Craftsman1579/lily58-keycaps/docs/adr/0012-case-tray-with-plate.md

# 0012 – Case: printed tray with a switch plate

- **Status:** proposed (draft v8, M2 standoffs in both variants; tenting pockets; snap, pocket size to be tuned)
- **Decided by:** owner (tray with plate, M2 screws and standoffs, no OLED, feet, tenting later,
  separate branch), derived (geometry)

## Context

The owner's board is a **PandaKB Lily58 RGB MX**: a Lily58 Pro derivative with hotswap MX sockets,
per-key and underglow RGB (underglow LEDs face down), two optional EC11 encoders in place of two
keys, ProMicro RP2040 (USB-C), TRRS, OLED. PandaKB publishes no PCB files. The original Lily58 Pro
KiCad file (kata0510/Lily58, MIT) is the best available source – and it fits: the 1:1 paper
template matches the owner's PCB exactly.

## Decision

- **Layout data** (`common/lily58_layout.scad`) is generated by `tools/kicad2scad.py` from
  `Pro/PCB/Lily58_Pro.kicad_pcb`: outline, 29 switch positions with rotation, 5 standoff holes
  (4.7 mm), 2 OLED holes, Pro Micro, TRRS, reset. The PCB is reversible; the data describe the right
  half from the top, the left half is the mirror image. Shared by the case and (later) the cap
  renders – the 1.5u thumb is rotated by 300° (30° from vertical), not 90° as in `tools/scene.py`.
- **Tray with plate** (`case/lily58_case.scad`): the tray follows the PCB outline (gap 0.6 mm,
  wall 4 mm, floor 3.6 mm, 3 mm 45° bevel round the bottom edge). Plate top = PCB top + 5 mm.
- **Plate over the wall, snapped in** (owner, v5: the plate sat loose in a rebate and looked
  poor): the plate (1.5 mm, MX) covers the wall top flush with the outside, its top edge with a 0.8 mm
  45° chamfer (owner: must print cleanly – the plate prints top down, a radius on the bed side
  would overhang too flat, a 45° chamfer does not). A tongue under its edge (1.2 mm, with a 1.5 mm bulge near the tip) clicks into a groove
  in the middle of the wall top (1.4 mm neck widening to 1.7 mm, 2 mm deep). The groove runs all
  round, also along the open controller zone, where a later cover can use it. `part="snap_test"`
  prints a 30 mm piece of wall and plate edge to tune the profiles. Plates are right and left
  again (the tongue is on one side) and are printed top down.
- **As flat as possible** (owner's wish, v3): plate top 15.2 mm above the desk (v2: 17.9); 16.8 mm
  since the tenting pockets (v7) need a 3.6 mm floor. Only
  the 5 mm PCB-to-plate-top of MX and the 3.5 mm parts below the PCB are fixed; the rest was
  trimmed (standoffs → bosses −2.3, floor −0.4). The keycaps (DES vs KAT) matter more
  than anything left in the case.
- **M2 hex standoffs, like the Choc variant** (owner, v8: liked the Choc mounting): an M2 standoff
  (female both ends, 2.7 mm across flats, passes the 4.7 mm PCB hole) sits in a hex pocket in each
  tray boss (Ø 6.5 mm, 4.0 mm high: the 3.5 mm parts below + 0.5). MX uses **10 mm** standoffs
  (z 2.6–12.6), ending 0.1 mm below the plate; sleeves under the plate (Ø 5.2 / 3.6 mm, the nearest
  switch housing is 2.9 mm from a hole centre) stand on the PCB, so the top screw clamps plate,
  sleeve and PCB onto the tray boss. M2x4 from below (2.5 mm of thread), M2x4 from the top (3.5 mm);
  both heads (Ø 3.7 × 1 mm, recesses Ø 4.1) flush in 1.1 mm recesses. Metal threads both ways instead of v6's M3x10
  tapping into a plastic boss. Earlier variants are in the history of this file.
- **Assembly:** standoffs into the pockets, M2x4 from below; PCB onto the tray bosses; plate with
  the switches on top (it snaps into the groove, the switches go into the hotswap sockets); M2x4 from
  the top through the plate into the standoffs.
- **No OLED** (owner's choice, v4): the plate leaves the controller zone open (x < 28.5, y > 55.5).
  Its edge towards the bottom row is 1.0 mm clear of the nearest keycap, so the cover keeps 1.3 mm
  between its edge and the screw head recesses.
- **Controller cover** (`part="cover"`, owner: 7.7 mm above the PCB, clicks into the tray): a 1.5 mm
  top whose underside is 7.7 mm above the PCB top (Pro Micro: 7.4 mm), walls on the tray wall with
  the plate's tongue in the groove, 1.5 mm inner walls along the plate edge (0.2 mm gap) down to the
  plate top, and two Ø 4.5 mm posts that press on the PCB round the two cover (OLED) holes. An M2x12
  from the top (head flush) goes through the cover and the PCB into a heat-set insert (3.9 mm across
  flats, 1.5 mm long) in the tray ring below the PCB: Ø 3.6 × 1.8 mm melt-in hole, then 2 mm room
  for the screw tip (it ends 0.8 mm below the insert). The screw clamps the PCB between post and
  ring. Printed top down. 45° chamfers on the top edges (owner): 3 mm along the case outline like the
  tray's bottom bevel, 0.8 mm along the plate like the plate's edge (the inner walls are 1.5 mm),
  1 mm on the vertical corner towards the keys. The USB plug reaches 9.15 mm above the PCB, the
  cover top 9.2 mm, so both port slots are open to the top of the cover (U-notches).
- **USB and TRRS** get rounded slots through the top wall, 2 mm closer to the
  inner edge than the KiCad positions (owner's test print). USB-C 16 × 10.5 mm (13 × 7.5 was too
  tight for the owner's cables), TRRS 9.5 × 8.5 mm; the two merge into one opening (hull), since
  the bridge between them would only be 0.35 mm. The Choc tray wall ends below the USB
  slot, so the Choc tray keeps separate slots and is unchanged; only its cover is new.
- **Rubber feet:** Ø 8 × 4 mm, recessed 1.4 mm (pockets Ø 8.4 mm, 0.6 mm floor above), sticking
  out 2.6 mm; five per half (the fifth in the thumb cluster tip, out to the chamfer, so the tip
  is supported; it is the front foot that clicks in behind the travel sleeve detent). Thinner feet
  (e.g. 8 × 2 mm) would save another 1.6 mm.
  The outer pair sits at x 139.9 (pockets reach the start of the bottom chamfer): tented, the half pivots
  on them. At x 132 the fully unfolded tenting feet (27°, inner edge 82.5 mm up, owner) tipped it
  onto its bottom edge and the rubber feet lost contact (from 18° on, now from 62° on). Moving the
  tenting pockets inwards would not have helped: even at x 0 the tilt stays at 23°, and the thumb
  screw blocks the front pocket.
- **Tenting** (v7): two folding feet per half (owner's, housing 66 × 20 × 5.5 mm, hinge on a short
  side) sit in pockets in the bottom, long side across the inner edge: one below the controller
  zone against the long back edge, just behind a screw head (y 87.3–107.6), one by the thumb cluster
  (y 12–32), both from x 25.5 to 91.8 – aligned, so the
  unfolded feet lift the half evenly (owner); the thumb cluster and its screw allow no smaller x –
  and clear of the five screw heads. The pockets are 2.9 mm deep, so the housings stick out 2.6 mm like the rubber feet
  and sit flush with them (owner's wish); that needs a 3.6 mm floor (0.7 mm above the pockets).
  The rubber foot by the thumb cluster moved to (12, 42).
- **Switch cutout 13.8 mm** (printed holes come out smaller than drawn). Confirmed by the plate fit
  test (`part="plate_test"`, 13.7–14.0 mm): the cutout with two notches (13.8) fits best (owner).
- **Choc variant** (`switch_type="choc"`, files `*_choc.stl`) for the owner's second Lily58 with
  Choc v1 switches at MX spacing: with the MX plate height the switches hung in the air above the
  PCB. The 1.9 mm plate now lies directly on the PCB (plate_above = plate_t = 1.9), so the tray wall
  ends at the PCB top. No plate bosses; instead **M2 hex standoffs** (owner's, female both ends,
  6 mm, 2.7 mm across flats / 3.1 across corners, so they pass the 4.7 mm PCB holes) sit in hex
  pockets in the tray bosses (z 3.1–9.1, 0.1 mm below the PCB top). An M2x4 from below holds each
  standoff, an M2x4 from the top pulls the plate onto the PCB and the PCB onto the boss; both heads
  (Ø 3.7 × 1 mm, recesses Ø 4.1) sit flush in 1.1 mm recesses. Metal threads both ways instead of the first draft's
  M3x6 tapping 1.3 mm into the plate (owner's idea). Same PCB outline, holes,
  ports and clearance below the PCB assumed as on the MX board – not measured on the Choc board.
- **1:1 paper template** (`template.pdf`/`.svg`, 100 mm scale bar) to lay the real PCB on.
- Work happens on the branch `lily58-case` until the case is verified.

## Measurements (MEASURE n in the code)

1. PCB size and thickness – confirmed with the paper template.
2. Standoff holes – confirmed with the paper template.
3. Encoders – not answered; the 14 mm plate cutout takes an EC11 shaft anyway.
4. USB-C centre 5.4 mm above the PCB top, no overhang.
5. TRRS jack axis 3.7 mm above the PCB centre (2.9 mm above its top). Position along the edge:
   from the KiCad data, the 9.5 mm slot covers both footprint variants.
6. OLED: removed by the owner.
7. Tallest part below the PCB 3.5 mm; area around the five holes is free.
8. No plate in the kit – the printed plate is the plate.
9. No wireless/battery.
10. Reset switch on the top, about 3.5 mm high.
11. (OLED window – obsolete.)
12. Highest point of the Pro Micro: 9.0 mm above the PCB bottom = 7.4 mm above its top.
13. M2 standoffs: 4/6/8/10 mm, 2.7 mm across flats (re-measured); MX uses 10 mm, Choc 6 mm.
17. Folding feet housing: 66 × 20 × 5.5 mm (pockets + 0.3 mm); exact size to confirm.
14. Switch cutout: 13.8 mm – confirmed by the plate fit test.
19. Cover (OLED) holes on the owner's PCB: Ø 2.1 mm, centres at x 2.2 / 25.05 mm from the inner
    edge, 47.25 mm below the top edge (Lily58 Pro data: 3.06 / 25.06, 47.91, Ø 2.4). Measured edge
    to edge from the PCB and from the case outside; both agree. Choc board not measured.
20. Heat-set inserts M2: 3.9 mm across flats, 1.5 mm long; screws M2 x 10/12/16/20.

## Consequences

- All parts are ready for a first test print; the switch cutout is confirmed.
- `case/build.sh` exports to `stl/case/`; check every part with `tools/f32.py` and `tools/shells.py`.

## Images

Both boards, rendered by `render/case.sh` (scene `render/case_scene.scad`): assembled, exploded,
section and controller cover for [MX](../img/case/mx_exploded.png) and
[Choc](../img/case/choc_exploded.png) (`docs/img/case/<board>_*.png`), and the
[bottom of the right tray](../img/case/bottom.png) (rubber feet black, tenting feet orange, M2 screws
grey; inner edge on the right).
