Craftsman1579/lily58-keycaps/docs/img/case/choc_carry2_section.png

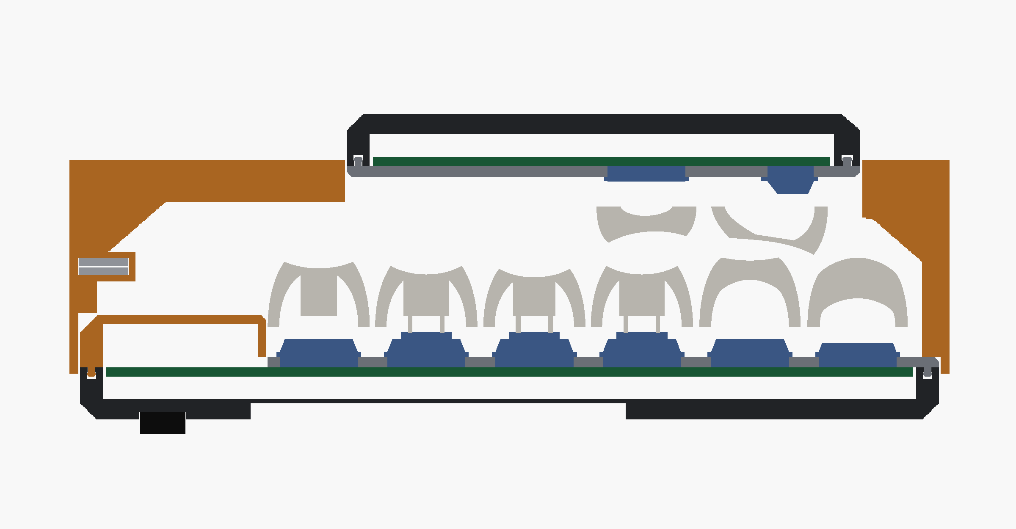
docs/img/case/choc_carry2_section.png
