Craftsman1579/lily58-keycaps/docs/img/case/mx_carry2.png

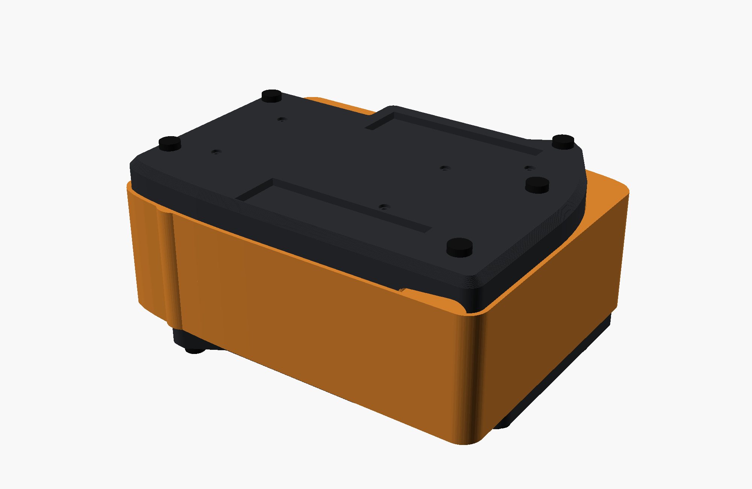
docs/img/case/mx_carry2.png
