Craftsman1579/lily58-keycaps/docs/img/case/mx_carry2_section.png

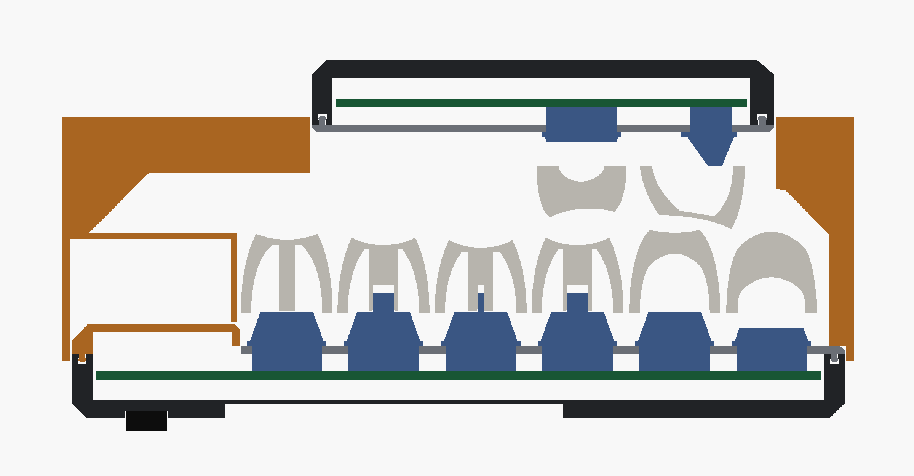
docs/img/case/mx_carry2_section.png
