Craftsman1579/lily58-keycaps/common/lily58_layout.scad

// Generated by tools/kicad2scad.py from kata0510/Lily58 Pro/PCB/Lily58_Pro.kicad_pcb
// (MIT, (c) 2018 Naoki Katahira). Do not edit by hand.
// RIGHT half seen from the switch side, mm, y up, origin = lower left of the PCB bbox.
// The left half is mirror([1, 0, 0]) of everything here.

lily58_pcb_thickness = 1.6;
lily58_pcb_size = [142.522, 106.327];

lily58_pcb_outline = [
  [33.249, 6.933], [34.925, 7.903], [42.295, 7.902], [49.665, 7.902], [57.034, 7.902], [64.404, 7.902],
  [71.773, 7.902], [79.143, 7.902], [86.512, 7.902], [93.882, 7.902], [94.184, 7.933], [94.466, 8.02],
  [94.721, 8.158], [94.943, 8.341], [95.126, 8.563], [95.264, 8.818], [95.351, 9.1], [95.382, 9.402],
  [95.382, 10.598], [95.382, 11.816], [95.382, 13.034], [95.382, 14.252], [95.382, 15.47], [95.382, 16.688],
  [95.382, 17.906], [95.382, 19.124], [95.453, 19.83], [95.657, 20.487], [95.979, 21.082], [96.406, 21.6],
  [96.924, 22.027], [97.519, 22.349], [98.176, 22.553], [98.882, 22.624], [104.149, 22.624], [109.417, 22.624],
  [114.685, 22.624], [119.952, 22.624], [125.22, 22.624], [130.487, 22.624], [135.755, 22.624], [141.022, 22.624],
  [141.325, 22.655], [141.607, 22.742], [141.861, 22.88], [142.083, 23.063], [142.266, 23.285], [142.405, 23.54],
  [142.492, 23.822], [142.522, 24.124], [142.522, 33.606], [142.522, 43.087], [142.522, 52.569], [142.522, 62.051],
  [142.522, 71.532], [142.522, 81.014], [142.522, 90.496], [142.522, 99.977], [141.341, 101.258], [137.952, 102.45],
  [132.588, 103.529], [125.483, 104.468], [116.87, 105.243], [106.982, 105.829], [96.052, 106.198], [84.313, 106.327],
  [73.906, 106.327], [63.498, 106.327], [53.09, 106.327], [42.682, 106.327], [32.274, 106.327], [21.866, 106.327],
  [11.459, 106.327], [1.051, 106.327], [0.839, 106.306], [0.642, 106.245], [0.463, 106.148], [0.308, 106.02],
  [0.18, 105.864], [0.083, 105.686], [0.022, 105.489], [0.001, 105.277], [0, 98.97], [0, 92.663],
  [0, 86.356], [0, 80.049], [0, 73.743], [0, 67.436], [0, 61.129], [0, 54.822],
  [0.198, 50.796], [0.553, 46.756], [1.083, 42.723], [1.81, 38.719], [2.75, 34.765], [3.926, 30.883],
  [5.354, 27.096], [7.056, 23.424], [8.731, 20.559], [10.407, 17.693], [12.082, 14.827], [13.758, 11.96],
  [15.434, 9.094], [17.11, 6.228], [18.785, 3.361], [20.461, 0.495], [20.554, 0.326], [20.66, 0.191],
  [20.777, 0.091], [20.905, 0.028], [21.044, 0], [21.193, 0.01], [21.351, 0.057], [21.519, 0.142],
  [23.195, 1.112], [24.871, 2.082], [26.546, 3.053], [28.222, 4.023], [29.898, 4.993], [31.573, 5.963],
];

// [x, y, rotation, row, column, width in u]
// row 0 = number row … 3 = bottom row, 4 = thumbs; column 0 = innermost of the 6x4 block,
// -1 = inner key next to the bottom row / 1.5u thumb.
lily58_keys = [
  [37.562, 93.414, 0, 0, 0, 1],
  [56.562, 95.814, 0, 0, 1, 1],
  [75.662, 97.204, 0, 0, 2, 1],
  [94.662, 95.814, 0, 0, 3, 1],
  [113.762, 91.014, 0, 0, 4, 1],
  [132.762, 89.514, 0, 0, 5, 1],
  [37.562, 74.314, 0, 1, 0, 1],
  [56.562, 76.714, 0, 1, 1, 1],
  [75.662, 78.114, 0, 1, 2, 1],
  [94.662, 76.814, 0, 1, 3, 1],
  [113.762, 72.114, 0, 1, 4, 1],
  [132.762, 70.614, 0, 1, 5, 1],
  [37.562, 55.314, 0, 2, 0, 1],
  [56.562, 57.714, 0, 2, 1, 1],
  [75.662, 59.014, 0, 2, 2, 1],
  [94.662, 57.714, 0, 2, 3, 1],
  [113.762, 52.914, 0, 2, 4, 1],
  [132.762, 51.414, 0, 2, 5, 1],
  [37.562, 36.314, 0, 3, 0, 1],
  [56.562, 38.614, 0, 3, 1, 1],
  [75.662, 40.014, 0, 3, 2, 1],
  [94.662, 38.614, 0, 3, 3, 1],
  [113.762, 33.914, 0, 3, 4, 1],
  [132.812, 32.414, 0, 3, 5, 1],
  [18.462, 45.914, 0, 3, -1, 1],
  [22.062, 16.414, 300, 4, -1, 1.5],
  [47.062, 17.414, 0, 4, 0, 1],
  [66.062, 19.664, 0, 4, 1, 1],
  [85.162, 19.664, 0, 4, 2, 1],
];

// M2 mounting holes for the plate standoffs (the PCB holes are 4.7 mm wide).
lily58_mount_holes = [[46.662, 83.814], [122.862, 81.614], [46.662, 45.814], [122.862, 43.414], [22.062, 28.614]];
lily58_mount_hole_d = 4.7;
// M2 holes for the OLED cover.
lily58_oled_holes = [[3.062, 58.414], [25.062, 58.414]];

// Pro Micro footprint origin (centre of the pin rows); USB faces +y (top PCB edge).
lily58_promicro = [18.062, 87.414];
// TRRS jack MJ-4PP-9 footprint origin; the plug opening faces +y.
lily58_trrs = [4.962, 104.114];
// Reset tact switch TVBP06.
lily58_reset = [2.062, 75.714];
// OLED 4-pin header, pin 1 (pins run +x).
lily58_oled_header = [13.762, 68.814];

module lily58_pcb_2d() { polygon(lily58_pcb_outline); }
