Craftsman1579/lily58-keycaps/(commit log)

2026-10-30 Lily58-Tastenkappen: Skript, README, Lizenz
    Skript erzeugt Lily58-Tastenkappen (deutsches Layout, Symbole, mehrfarbige
    Legenden) im DES- und KAT-Profil, seitwaerts gedruckt fuer FDM, mit plan
    geschnittenen Seiten und herausziehbarer Stem-Stuetze. README beschreibt den
    Druck, die Aenderungen an beiden Vorlagen und die Credits; GPL-3.0 wegen des
    uebernommenen DES-Codes.
2026-10-30 README: Renderbilder des DES-Satzes
    Gesamter Satz mit und ohne Beschriftung in Lily58-Anordnung sowie eine
    Nahaufnahme einzelner Kappen, gerendert mit plan geschnittenen Seiten.
2026-10-30 README in English, add photos of printed caps
    Translate the README to English and rename the render images accordingly.
    Add three photos of printed caps (GUI, blank, G); EXIF/GPS metadata and the
    embedded motion-photo video were removed before adding them.
2026-10-30 Add US layout set (LAYOUT=us) with example render
    des-all now takes LAYOUT=us for a US QWERTY set following the Lily58
    default keymap (` - ; ' [ ] , . /), with the same modifier symbols, thumb
    keys and blank caps as the German set. The key list is assembled per layout;
    globbing is disabled while reading it so that [ is taken literally.
2026-10-30 Add KAT set (fit test, US layout, renders) and side profiles
    kat-test is now a fit test like des-test (blank home-row caps with flat
    sides and removable support, one file per tolerance; the old per-row test
    from before the side cut is removed). kat-all takes LAYOUT=us as well.
    README presents DES and KAT side by side with renders, a side profile of
    one column for both profiles and a note on the keycap_playground license.
2026-10-30 Add draft case: tray with switch plate (ADR 0012)
    - tools/kicad2scad.py generates common/lily58_layout.scad from the
    kata0510 Lily58 Pro KiCad file (outline, switches, holes, parts)
    - case/lily58_case.scad: tray with posts through the PCB holes, plate on
    a rebate, recessed 8 mm feet, USB/TRRS notches, plate fit test and a
    1:1 paper template; case/build.sh exports to stl/case/
    - Values marked MEASURE still need checking against the PandaKB PCB
    [lily58_case.scad, lily58_layout.scad]
2026-10-30 Case: apply measured USB height and bottom clearance
    The paper template matches the PandaKB PCB, so the kata0510 outline and
    hole positions stay. ADR 0012 lists the measurements still open.
    [lily58_case.scad]
2026-10-30 Case v2: M3 standoffs below the PCB, controller cover on the plate
    - 6 mm M3 hex standoffs in floor pockets, button head from below,
    socket head from the top; printed washers seat the PCB
    - Plate is held by the switches only and carries a cover box over the
    controller zone (no OLED), with a reset hole and USB/TRRS slots
    - Measured USB, TRRS and Pro Micro heights applied (ADR 0012)
    [lily58_case.scad]
2026-10-30 Case: switch mounting to M2, switch cutout 13.8 mm
    The owner's standoffs and screws are M2 (hex 2.8 mm across flats), not
    M3: smaller pocket and screw holes, flush button heads below, 3.8 mm
    socket heads on top. First fit test gave a 13.8 mm switch cutout.
    [lily58_case.scad]
2026-10-31 Add travel lids: snap-on lid per half, magnets back to back (ADR 0013)
    - Lid slides over the tray wall; three ribs click into a groove around it
    - Magnet pockets in the floors line up when the halves lie bottom to bottom
    - lid_test part to tune the snap; part="travel" renders the package
    - Keycap height and magnet size still to measure
    [lily58_case.scad]
2026-10-31 Replace travel lids with a two-chamber sleeve (ADR 0013)
    The lids needed a groove and magnet pockets in the tray. The sleeve takes
    both halves keys up in stacked chambers, held by a ridge the rubber feet
    click over, so the tray is back to its previous shape.
    [lily58_case.scad]
2026-10-31 Case v3: as flat as possible, connectors 2 mm closer to the edge
    - PCB on printed bosses with M2x8 self-tapping screws instead of 6 mm
    standoffs; washer moves on top of the PCB
    - 2 mm floor, feet recessed 1.4 mm, 3 mm bevel round the bottom edge
    - Lower controller cover (3.9 mm above the plate), USB slot as a notch
    - USB and TRRS slots 2 mm towards the inner edge (owner's test print)
    - Plate top 15.2 mm above the desk instead of 17.9 mm
    [lily58_case.scad]
2026-10-31 Case v5: plate covers the wall and snaps into a groove; open controller zone
    - Plate lies on the wall top flush with the outside, top edge rounded
    - Tongue with a bulge under the plate edge clicks into a groove in the
    wall top; snap_test prints a piece of both to tune the fit
    - Access holes in the plate above the five screws
    - Controller cover removed (separate cover later); pilot holes in the
    rings under the OLED holes
    [lily58_case.scad]
2026-10-31 Case v6: M3 screws from below into bosses under the plate
    Five M3x10 button-head screws run up through floor, tray bosses and PCB
    and tap into bosses under the plate, clamping the PCB. Washers and the
    access holes in the plate are gone; the plate top stays closed.
    [lily58_case.scad]
2026-10-31 Case: 45° chamfer instead of a radius on the plate's top edge
    The plate prints top down, so the edge lies on the bed side; a radius
    would overhang too flat there, a 45° chamfer prints cleanly.
    [lily58_case.scad]
2026-10-31 Case v7: pockets for two folding tenting feet per half
    - Pockets 66.3 x 20.3 x 2.9 mm across the inner edge, clear of the screw
    heads; the 5.5 mm housings sit flush with the rubber feet
    - Floor 3.6 mm (0.7 mm above the pockets); M3 heads (3 mm) recessed flush
    - Rubber foot by the thumb cluster moved to (12, 42)
    [lily58_case.scad]
2026-10-31 Add DES for Choc v1 switches (des-choc-all, des-choc-test)
    DES profile 4 mm lower with Choc v1 legs (from pseudoku's choc_stem) and a
    round bridge instead of the cross stem; legs narrowed per side by the
    tolerance (default 0.025 -> 1.15 mm, from the fit test). Caps are rotated by
    90 degrees and printed on their front face so the legs stand side by side,
    with a removable plate support under both legs. MX output is unchanged.
    See ADR 0014.
2026-11-01 Case: Choc variant with the plate on the PCB; align tenting pockets
    switch_type="choc" for the owner's second Lily58 with Choc v1 switches:
    with the MX plate height the switches hung in the air, so the 1.9 mm plate
    now lies directly on the PCB and the tray wall ends at the PCB top. No plate
    bosses; deeper head recess for M3x6 screws (1.3 mm thread in the plate).
    build.sh also exports tray/plate *_choc.stl.
    Also: the rear tenting pocket moves to x 25.5 against the back edge, so both
    folding feet lift the half along one line.
    [lily58_case.scad]
2026-11-01 Case (Choc): M2 hex standoffs instead of M3x6 into the plate
    The M3x6 only tapped 1.3 mm into the 1.9 mm plate. Now 6 mm M2 standoffs
    (female both ends, 2.7 mm across flats) sit in hex pockets in the tray
    bosses and reach through the PCB holes to 0.1 mm below the PCB top. An M2x4
    from below holds each standoff, an M2x4 from the top clamps plate and PCB;
    both heads sit flush in 1.1 mm recesses. MX variant unchanged.
    [lily58_case.scad]
2026-11-01 Case: switch cutout 13.8 mm confirmed by the plate fit test
    [lily58_case.scad]
2026-11-01 Case v8: MX mounted like Choc with M2 hex standoffs; 3.7 mm heads
    - MX: 10 mm M2 standoffs in hex pockets in the tray bosses, ending just
    below the plate; sleeves under the plate clamp the PCB. M2x4 from
    below and from the top instead of M3x10 tapping into plastic
    - Head recesses Ø 4.1 mm for the owner's 3.7 mm heads (MX and Choc)
    [lily58_case.scad]
2026-11-01 Case: carry case with two frames and a middle plate (ADR 0015)
    The halves face each other keys inwards, a frame rests on each switch
    plate rim with a skirt round the edge, a 2 mm middle plate sits between
    them, filament dowels align the parts and rubber bands hold the stack.
    Wall height follows caps_above, now an 18 mm estimate for the Choc
    board (DES-Choc R1 is 12.8 mm tall); to be confirmed by measurement.
    [lily58_case.scad]
2026-11-01 Carry case: 23.5 mm keycap height, one frame for MX and Choc
    The frame height now comes from cc_caps (23.5 mm above the plate, set by
    the owner) instead of the per-board caps_above estimate, so the MX board
    fits as well. The controller zone step is the thinner MX plate (1.5 mm):
    on the Choc board it stays 0.4 mm clear, the frame still rests on the
    plate. caps_above (sleeve) is back to 24 mm.
    [lily58_case.scad]
2026-11-01 Docs: carry case renders (closed, exploded, section)
2026-11-01 Case: render script for the carry case images
    case/render_carry.sh exports the parts to stl/case/render/ and renders
    the closed, exploded and section views from case/carry_scene.scad with
    the DES-Choc caps into docs/case_carry_*.png.
    [carry_scene.scad]
2026-11-01 Case: cover holes at the positions measured on the owner's PCB
    The two cover (OLED) holes on the owner's board are 2.1 mm wide and sit
    0.65 mm closer to the top edge than in the Lily58 Pro data; hole 1 is
    0.9 mm closer to the inner edge. The tray rings and pilots now use
    cover_holes (MEASURE 19); the paper template shows the measured holes
    with a cross. Choc board not measured, same positions assumed.
    [lily58_case.scad]
2026-11-01 Case: controller cover with heat-set inserts
    The cover's underside is 7.7 mm above the PCB (Pro Micro 7.4 mm); it
    clicks into the wall groove with the plate's tongue, has inner walls
    along the plate edge and two posts that press on the PCB round the
    cover holes. M2x12 from the top go through cover and PCB into heat-set
    inserts (3.9 mm across flats, 1.5 mm long) in the tray rings, which
    replace the pilot holes. The carry case frame is now open over the
    cover (7.8 mm deep) instead of resting on the wall top in the
    controller zone. Renders updated.
    [carry_scene.scad, lily58_case.scad]
2026-11-01 Case: chamfered controller cover, plate edge 1.1 mm closer to the keys
    The cover gets 45-degree chamfers on its top edges: 3 mm along the case
    outline like the tray's bottom bevel, 0.8 mm along the plate, 1 mm on
    the corner towards the keys. The plate edge in the controller zone moves
    from y 56.6 to 55.5 (1.0 mm clear of the nearest keycap), so the screw
    head recesses keep 1.3 mm to the cover edge instead of 0.23 mm. The USB
    plug reaches the cover top, so both port slots are open upwards in the
    cover. Carry case renders updated.
    [lily58_case.scad]
2026-11-02 Case: outer rubber feet moved to the outer edge so they still touch when tented
    Fully unfolded tenting feet tilt the half by about 27 degrees. With the outer
    rubber feet at x 132 it tipped onto its bottom edge from 18 degrees on; at x 138
    only from 49 degrees on.
    [lily58_case.scad]
2026-11-02 Case: outer rubber feet out to the start of the bottom chamfer
    [lily58_case.scad]
2026-11-02 Case: fifth rubber foot in the thumb cluster tip
    Out to the chamfer on both edges. It is now the front foot, so the travel
    sleeve detent moves in front of it.
    [lily58_case.scad]
2026-11-02 Docs: case tray bottom view with rubber feet and tenting pockets
2026-11-02 Docs: reproducible renders for all keycap variants and both case boards
    - render/keycaps.sh: sets, blank sets, close-ups for DES, DES-Choc and KAT
    (German and US), side profiles of all three profiles; flat cuts in
    render/flat.scad, scenes from tools/scene.py (now also des-choc)
    - render/case.sh + case_scene.scad: assembled, exploded, section and
    controller cover for the MX and the Choc board, tray bottom, carry case
    for both boards, travel sleeve; replaces case/render_carry.sh
    - render/render_all.sh runs both
    - Images move to docs/img/{keycaps,case,photos}/
    - README split into self-contained parts (keycaps, case, travel, rendering,
    templates, credits), marked for later separate doc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
    [carry_scene.scad, case_scene.scad, flat.scad, side_profiles.scad]
2026-11-02 DES-Choc: 2.9 mm legs, thumb legs rotated 90°; larger USB-C opening
    - Choc legs fixed at 2.9 mm length (3.1 was too long in the printed set).
    - Thumb caps: legs rotated by 90° inside the cap, caps printed on their
    side like MX (side chords measured), same leg support as the rows.
    - Case: USB-C slot 16 x 10.5 mm (was 13 x 7.5), merged with the TRRS slot
    in the MX tray and both covers; Choc tray unchanged.
    - Renders and docs updated (README, ADR 0012, ADR 0014, CLAUDE.md).
    [case_scene.scad, lily58_case.scad]
2026-11-03 DES-Choc: only the 1.5u thumb gets rotated legs
    The 1u thumbs (T1/T2) were rotated by mistake in 6af683c; their switches
    sit like the rows. They are rotated and printed on the front face again
    with the original chords. Only the 1.5u thumb keeps legRot=90.
    Renders (keycap sets, Choc carry case) and docs updated.
    [case_scene.scad]
2026-11-03 Carry case: own frames per board from measured keycap heights
    - cc_caps per switch_type (owner, measured): MX 23.2 mm, Choc 18 mm,
    plus 1 mm cc_air; frames 24.2 / 19 mm (was 24.5 for both).
    - build.sh also exports carry_frame_right/left_choc.stl; middle plate
    stays shared.
    - Carry renders updated; section view centred per board (MX was cut off).
    - ADR 0015, README, CLAUDE.md updated.
    [lily58_case.scad]
2026-11-07 DES: overlap the dish halves along their own path
    The front dish half was shifted 0.05 mm in global y so the two halves
    overlap. With a tilted top this left a step of 0.05*tan(tilt) across the
    middle of the dish (R1 0.018 mm, R2 0.012 mm, R4 0.008 mm), which printed
    as a ridge running left to right over the top of the caps. The half is
    now moved back along its own sweep path; the surfaces meet without a step.
    Affects DES and DES-Choc.
2026-11-07 KAT tolerance 0.025, re-rendered images for v1.2
    - kat-all defaults to stem tolerance 0.025 (owner's choice after the
    fit test, ADR 0004); render/keycaps.sh uses the 0.025 KAT sets
    - Keycap and case images re-rendered from the fixed DES/DES-Choc sets
    - README, ADRs and CLAUDE.md updated for v1.2 (DES, DES-Choc and KAT,
    German and US)
2026-11-07 Document the confirmed DES dish fix
    A test print of R1 with the v1.2 dish fix shows no ridge across the top
    any more. Recorded in ADR 0009 and the README, open item removed.
2026-11-08 Carry case: compact variants with magnets, cable compartment for MX
    MX frames lose the middle plate and gain a cable compartment over the
    controller covers (81 mm instead of 84). New compact variant for both boards
    (ADR 0016): the left half is turned over the long axis so the number rows
    face the low rows, four 10 x 1.4 mm magnets per frame replace the rubber
    bands and a printable roof closes the notches. MX 75.6 mm with two flat
    cable compartments, Choc 59.2 mm without one.
    Fix the swapped left/right carry frame exports, use the measured row heights
    in the render scene and draw schematic switches in all case images. README
    also documents the German layout from the previous commit.
    Co-Auth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
    [case_scene.scad, lily58_case.scad]
